IowaScaledEngineering/ckt-axle/pg/ckt-axle-indicator-v1.0-88cc398/ckt-axle-indicator.pdf

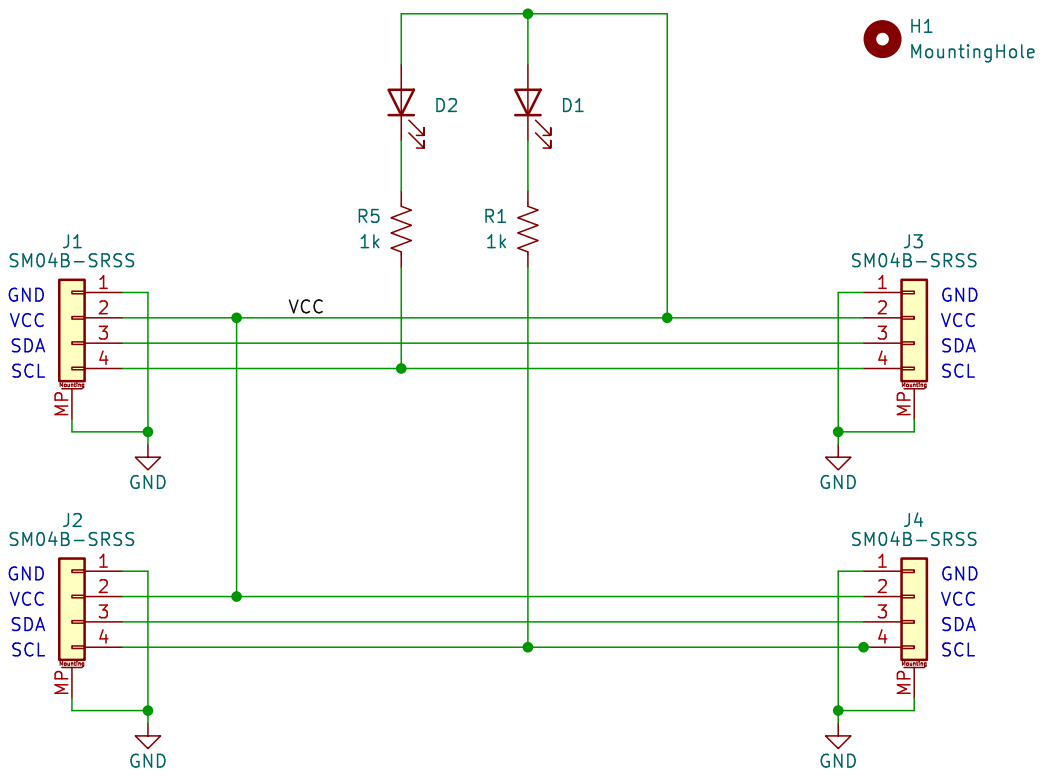
[picture p1: page 1]

Id: 1/1 Title: File: ckt-axle-indicator.kicad_sch Sheet: / GND
