IowaScaledEngineering/ckt-axle/pg/ckt-axle-v1.2-cb94762/ckt-axle.pdf

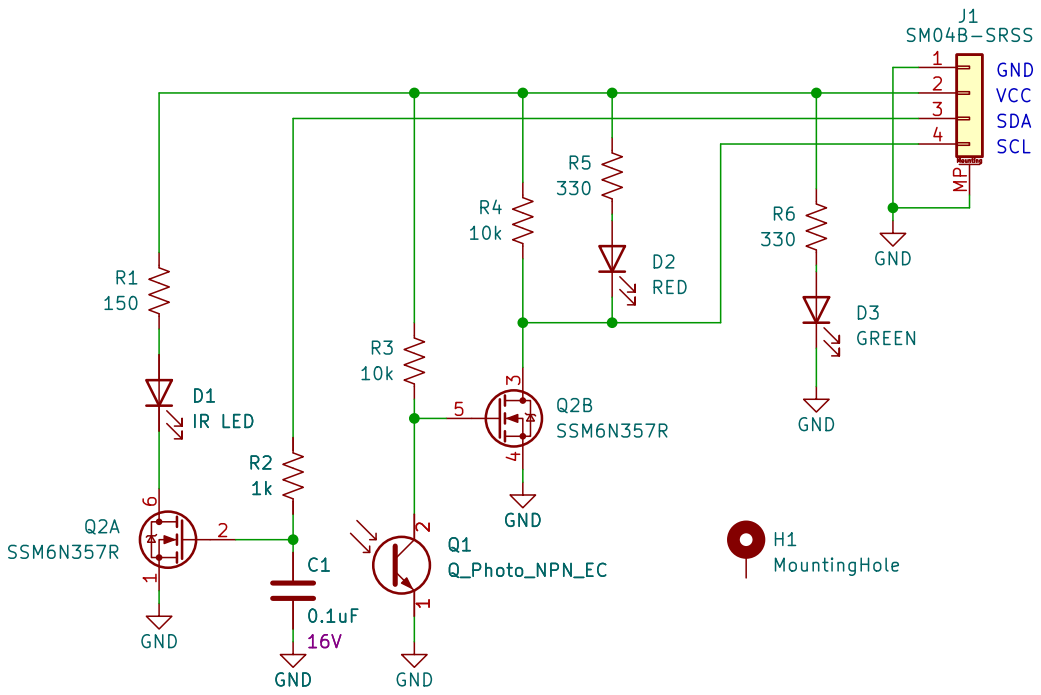
[picture p2: page 1]

File: ckt-axle.kicad_sch Sheet: /
Id: 1/1 Title:
