IowaScaledEngineering/ckt-axle/pg/ckt-axle-bar-array-v1.0-eabeffb/ckt-axle-bar.pdf

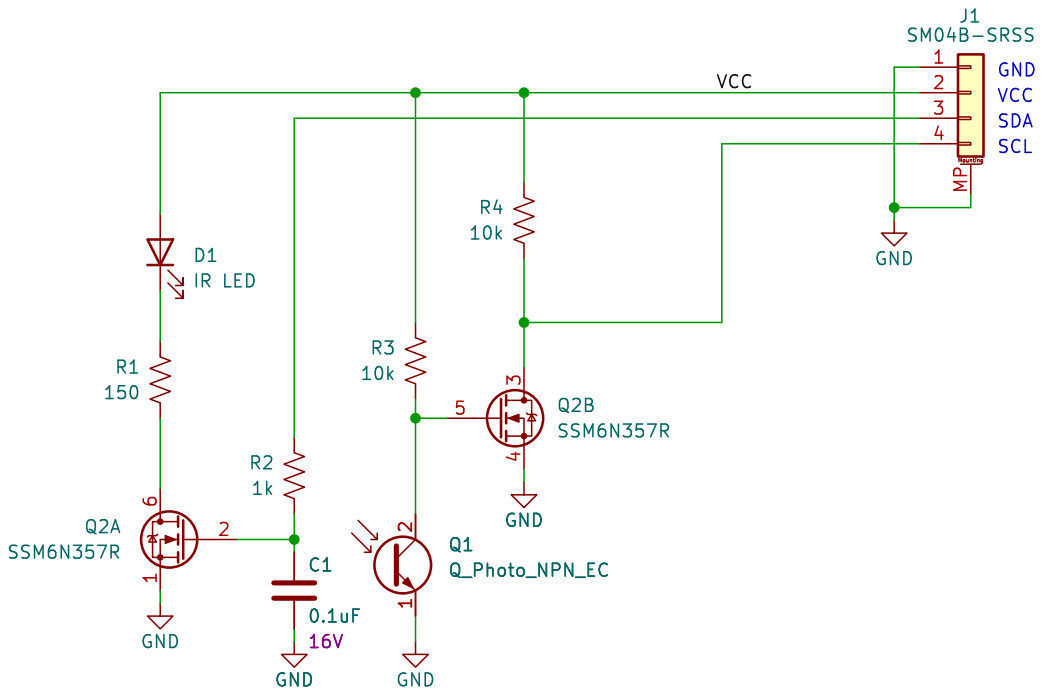
[picture p3: page 1]
