IowaScaledEngineering/ckt-axle/pg/ard-axlesim-v1.0-99a1535/ard-axlesim.pdf

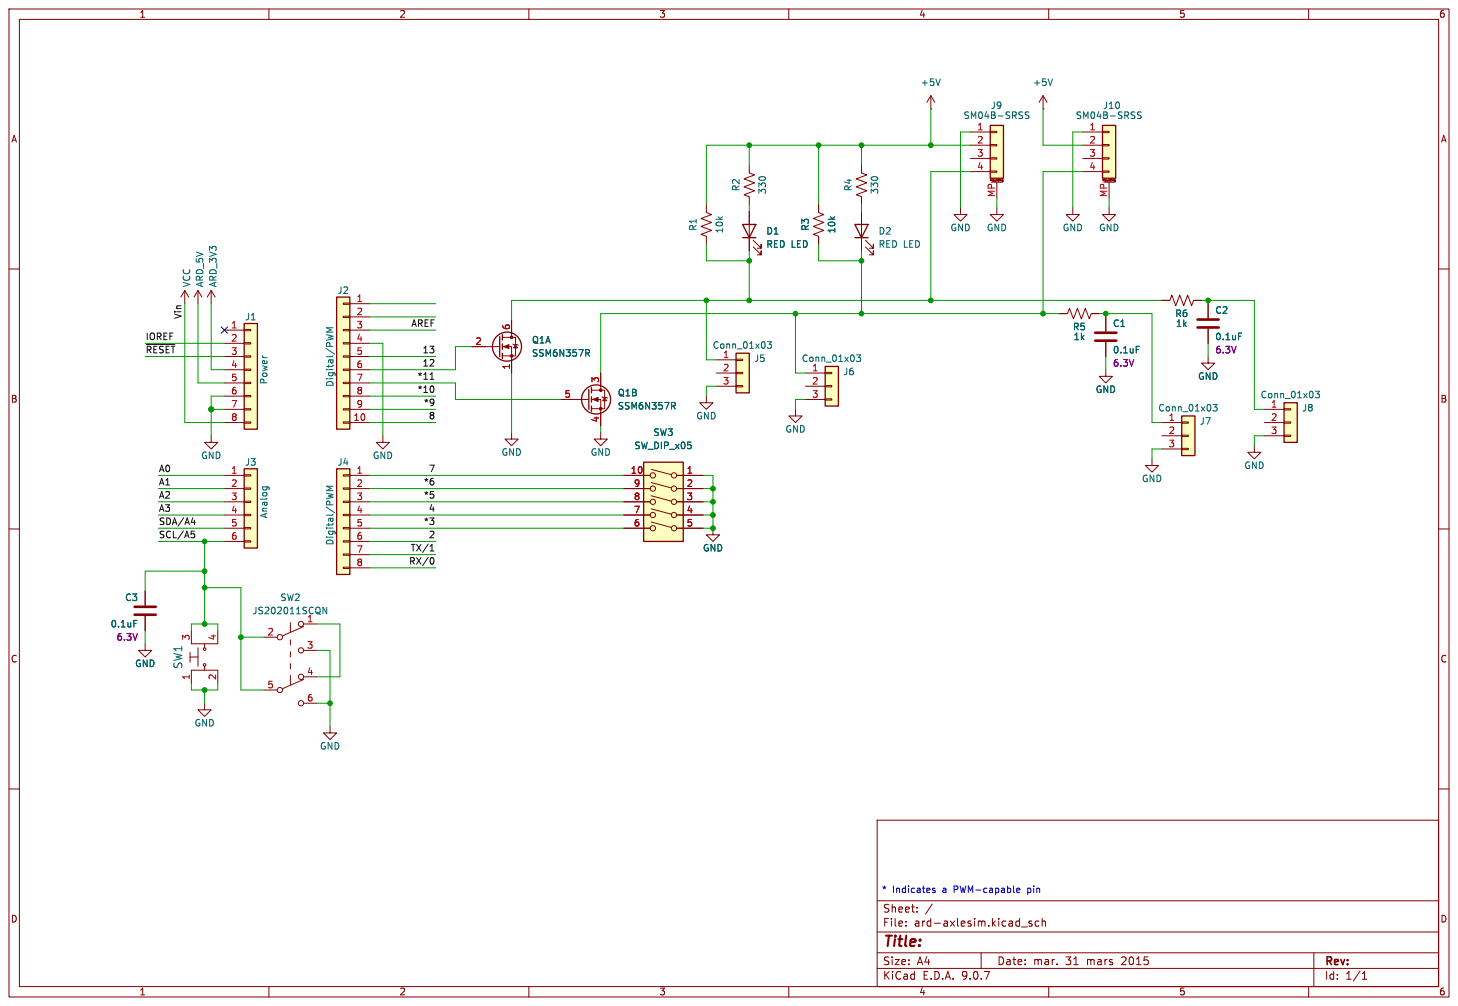
[picture p4: page 1]
