IowaScaledEngineering/ckt-axle/pg/ckt-axle-v1.0-fb1a4a8/ckt-axle.pdf

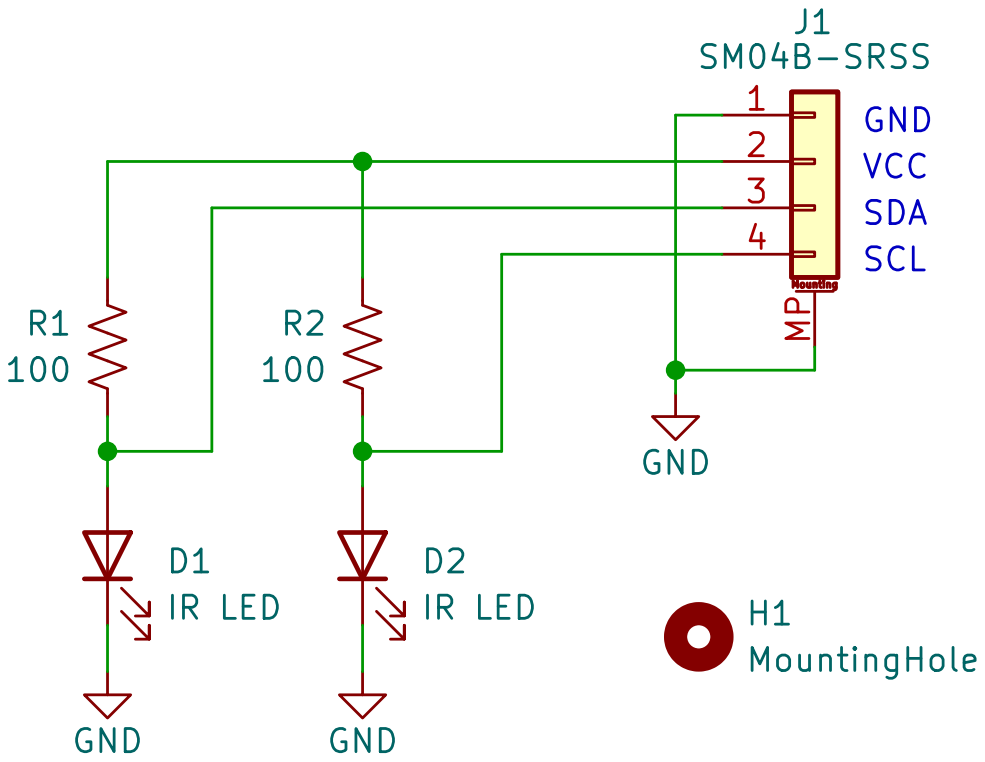
[picture p5: page 1]

IR LED
File: ckt-axle.kicad_sch Sheet: / H1MountingHole GND
