IowaScaledEngineering/ckt-axle/(commit log)

2024-07-09 Sent to fab July 2024
    [ckt-axle-NPTH.drl, ckt-axle.drl, ckt-axle.gbl, ckt-axle.gbo, ckt-axle.gbp, ckt-axle.gbr, ckt-axle.gbs, ckt-axle.gm1]
2024-08-01 v1.1 design with two LEDs
    [ckt-axle.kicad_pcb, ckt-axle.kicad_sch]
2024-08-01 v1.2 with 1206 LED
    [ckt-axle.kicad_pcb, ckt-axle.kicad_sch]
2024-08-01 Bracket design
    [axle-bracket v1.stl]
2024-08-01 Added gate pull-down
    [ckt-axle.kicad_pcb, ckt-axle.kicad_sch]
2024-08-20 Updated v1.2 with 1206 phototransistor
    [ckt-axle.kicad_pcb, ckt-axle.kicad_sch]
2024-08-20 Added RC for Q2A gate
    [ckt-axle.kicad_pcb, ckt-axle.kicad_sch]
2024-08-20 Minor tweaks
    [ckt-axle.kicad_pcb, ckt-axle.kicad_sch]
2024-08-25 Added D1/Q1 labels
    [ckt-axle.kicad_pcb]
2024-08-25 Fixed DRC
    [ckt-axle.kicad_pcb]
2024-08-26 pg 1.2
    [ckt-axle-NPTH.drl, ckt-axle.drl, ckt-axle.gbl, ckt-axle.gbo, ckt-axle.gbp, ckt-axle.gbr, ckt-axle.gbs, ckt-axle.gm1]
2026-03-15 Axle simulator
    [ard-axlesim.kicad_pcb, ard-axlesim.kicad_sch]
2026-03-15 Added DIP switch
    [ard-axlesim.kicad_pcb, ard-axlesim.kicad_sch]
2026-03-19 Updates after review
    [ard-axlesim.kicad_pcb, ard-axlesim.kicad_sch]
2026-03-19 Added labels to DDIP switch
    [ard-axlesim.kicad_pcb]
2026-03-19 pg axlesim 1.0
    [ard-axlesim-NPTH.drl, ard-axlesim.drl, ard-axlesim.gbl, ard-axlesim.gbo, ard-axlesim.gbp, ard-axlesim.gbr, ard-axlesim.gbs, ard-axlesim.gm1]
2026-05-02 Bar version of axle counter
    [ckt-axle-bar.kicad_pcb, ckt-axle-bar.kicad_sch]
2026-05-02 Fixed some errors
    [ckt-axle-bar.kicad_pcb]
2026-05-29 Moved trace away from edge
    [ckt-axle-bar.kicad_pcb]
2026-06-19 PG bar sensor 1.0
    [ckt-axle-bar-NPTH.drl, ckt-axle-bar.drl, ckt-axle-bar.gbl, ckt-axle-bar.gbo, ckt-axle-bar.gbp, ckt-axle-bar.gbr, ckt-axle-bar.gbs, ckt-axle-bar.gm1]
2026-06-30 Added indicator board
    [ckt-axle'indicator.kicad_pcb, ckt-axle'indicator.kicad_sch]
2026-06-30 Fixed filenames
    [ckt-axle-indicator.kicad_pcb, ckt-axle-indicator.kicad_sch]
2026-06-30 Added text
    [ckt-axle-indicator.kicad_pcb]
2026-07-04 Indicator board
    [axle-bracket v1.stl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]
2026-08-31 Added manual kikit tab
    [ckt-axle-bar.kicad_pcb]
2026-08-31 Sensor array panel
    [ckt-axle-bar-array.kicad_pcb]
2026-08-31 Updated mousebites
    [ckt-axle-bar-array.kicad_pcb]
2026-09-01 PG ckt-axle-bar 1.0
    [ckt-axle-bar-array-NPTH.drl, ckt-axle-bar-array.drl, ckt-axle-bar-array.gbl, ckt-axle-bar-array.gbo, ckt-axle-bar-array.gbp, ckt-axle-bar-array.gbr, ckt-axle-bar-array.gbs, ckt-axle-bar-array.gm1]
