IowaScaledEngineering/ckt-axle/(notices)

Notices in the files:
kicad/ckt-axle/ckt-axle.kicad_pcb:
©2024 CC BY-SA
kicad/ckt-axle-indicator/ckt-axle-indicator.kicad_pcb:
©2026 CC BY-SA
kicad/ckt-axle-bar/ckt-axle-bar.kicad_pcb:
©2025 CC BY-SA
